DrFlGd/Arcade-Cabinet-Workshop/docs/renders/web_app_parts.png

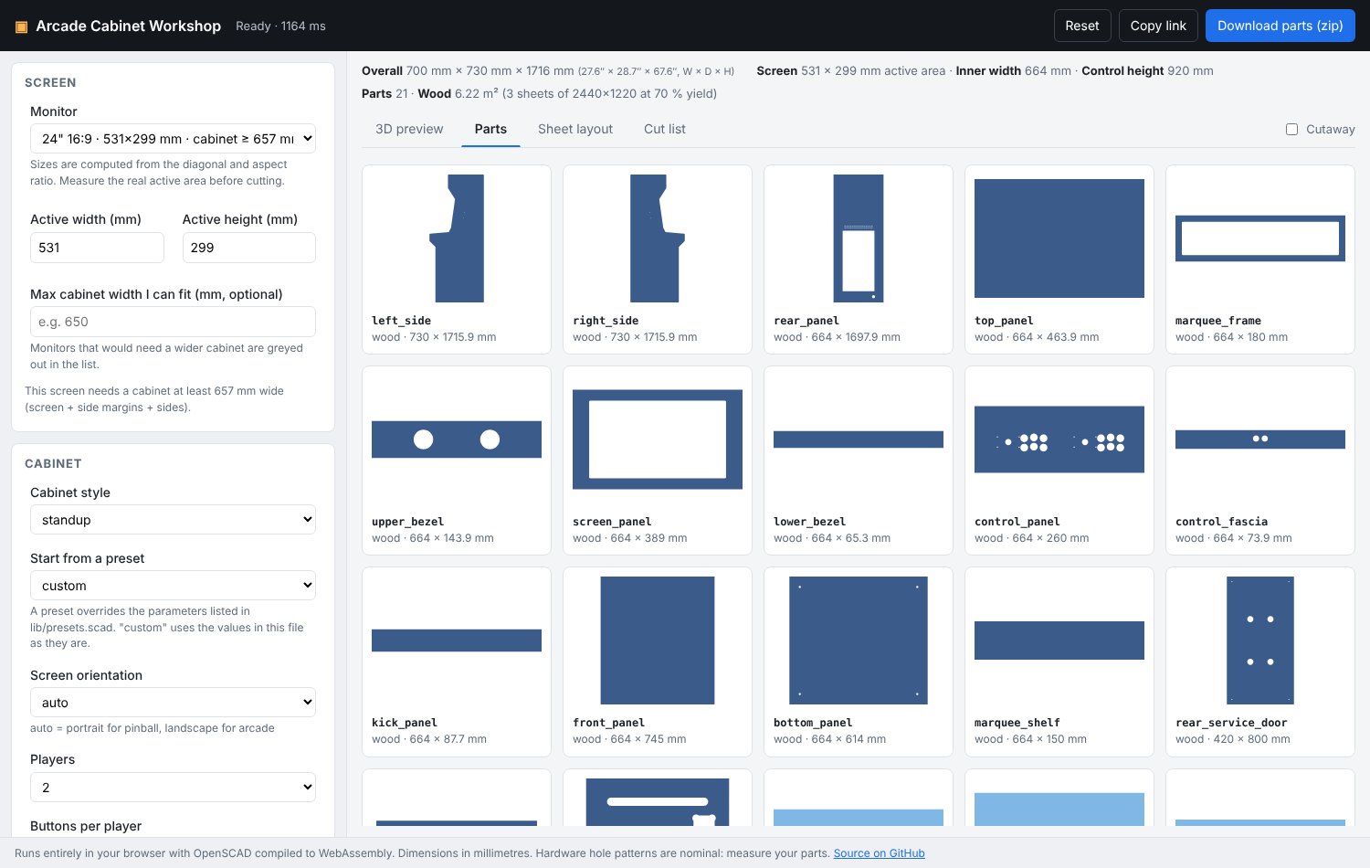
docs/renders/web_app_parts.png
