DrFlGd/Arcade-Cabinet-Workshop/(commit log)

2026-09-26 Add parametric arcade cabinet generator
    [arcade_cabinet_workshop.scad]
2026-10-25 v8: derive the cabinet from the panel stack, split into lib/, add tests
    Rewrite of the generator. The side profile is now built from the list of
    cross panels so the shell is closed for every style and preset, butt
    joints are trimmed for stock thickness, and geometry is checked by
    asserts with readable messages.
    - New panels: top, upper/lower bezel, kick panel, marquee frame with a
    window, marquee shelf; pinball playfield solved from the screen with a
    backbox that has its own depth.
    - Presets moved to a data table with switchable geometry / material /
    screen / controls groups; hardware hole patterns moved to templates.
    - Blind tab pockets export as separate drawings; dogbones offset al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
    [arcade_cabinet_workshop.scad, view.scad]
2026-10-25 Add browser-only web app and scene output mode
    web/ is a static front end that runs OpenSCAD as WebAssembly in a worker
    pool: a monitor picker that shows the cabinet width each screen needs, a
    parameter form generated from the Customizer block of the main file, a
    Three.js preview with cutaway, a parts gallery, the sheet layout, the cut
    list, a zip export with DXF and SVG for every part, and shareable links.
    The generator gains output_mode "scene" (JSON lines: overall size, cut
    list, layout rects and 4x4 placement matrices for every 3D element) and
    "all_sheet" (every outline in one drawing), so a viewer can build the 3D
    preview from 2D exports instead of a slow CSG union.
    GitHub Actions: re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
    [arcade_cabinet_workshop.scad]
2026-10-26 Fix rear door placement, add backglass monitor, stop plexi flicker
    - Rear panel measures up from the floor (face no longer reversed), so the
    service-door opening, vents and cable hole line up with the door in 3D
    and in the exported part. Side-panel joinery is unchanged.
    - Pinball: backglass_screen_width/height and margins size the backbox
    opening; vpin_backbox_height = 0 sizes the backbox; the automatic
    cabinet width is the wider of the playfield and backglass needs.
    - Web app: backglass monitor picker for pinball styles; plexi drawn with
    polygon offset and no depth write so it no longer z-fights its panel;
    screen preview moved behind its panel.
    - Render tests: large-backglass va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
    [arcade_cabinet_workshop.scad]
